cy-rhino/Mini/Rhino Mini Picture.png

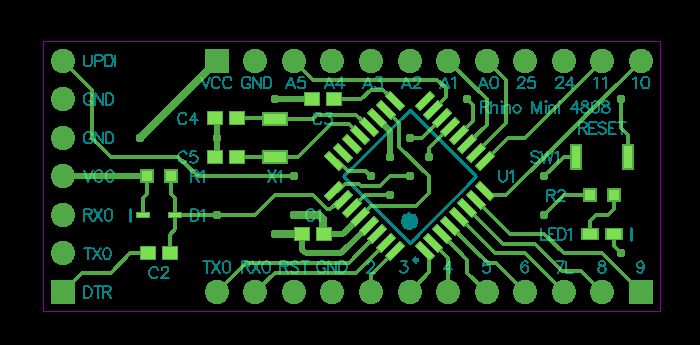
Rhino Mini Picture.png
