cy-rhino/Mini/Rhino Mini Schematic.pdf

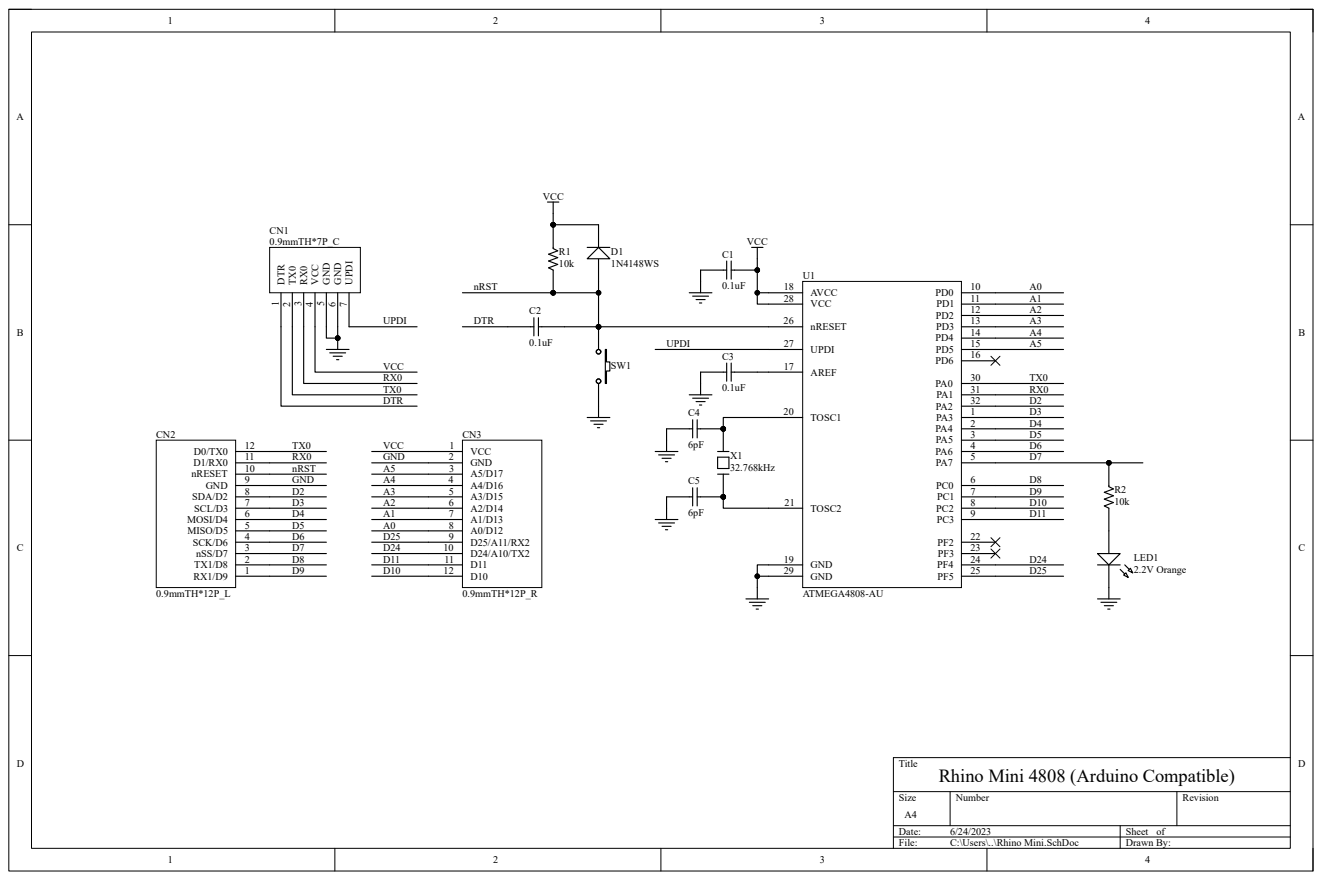
[picture p2: page 1]

Title
Rhino Mini 4808 (Arduino Compatible)
